Salah3beed/ackerman-steering-car-using-atmega328p/README.md

# Ackerman-Steering-Car-using-ATMega328p
The project files will be uploaded once the uni approves the open source process.
