Salah3beed/ackerman-steering-car-using-atmega328p/Proposal.pdf

# Proposal

# Hand Gesture Controlled Obstacle Avoidance Smart Robotic Car

# Spring 2021-2022

# MCTR601

1

Under supervision of: Prof. Ayman Al Badawy

# Table of Contents

### I. Introduction

i. Team details

ii. Brief intro about the project

### II. Required components

### III. Functional diagram

### IV. Closed Loop control diagram

I. Introduction

The Team:

Name | ID | Tutorial
Salaheldin Mohamed Salah Hussein | 49-18052 | T-32
Shehab Ibrahim | 49-7639 | T-32
Zeyad Tarek | 49-16945 | T-26

Robots are playing an essential part in automation in various areas, including construction, military, medical, and industrial. We used hand motion to drive the car in this project. We have used an accelerometer, which operates on acceleration, for this purpose and we created an ADC converter using 4 channel comparator circuit.

Generally, a transmitting circuit is used in the hand, which contains an RF Transmitter and accelerometer. This will transmit signals to the receiver circuit so that it can do the required task like moving forward, reverse, turning left, turning right and stop.

The accelerometer gives an Analog output so we need to convert these Analog signals into digital. For this purpose, we will use a 4-channel comparator circuit using op amps in place of the ADC (so as to not use an extra microcontroller or an expensive ADC IC). By setting reference voltage, we get a digital signal and then apply this signal to HT12E encoder to encode data or converting it into serial form and then send this data by using RF transmitter into the environment.

At the receiver end, we have used an RF receiver to receive data and then connecting the signals to HT12D decoder. The decoder IC converts received serial data to parallel to be read by the ATMega328p MCU. According to the received data, we drive the car by using two DC motor in forward, reverse, left, right and stop direction.

The robotic car is designed also to avoid any obstacle that may exist along its path, and that is achieved using the ultrasonic sensor attached to the receiver circuit. Using closed loop control, feedback from the sensor, a proportional controller unit makes a correction and this in turn, this changes PWM signal duty cycle, which in turn controls the speed of the motors to change the direction of movement.

II. Required components

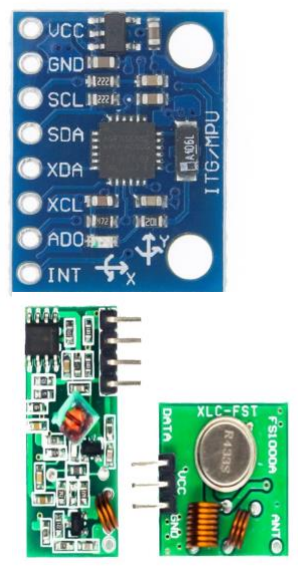
[picture p41: figure]

- ATMega328p
- DC Motors

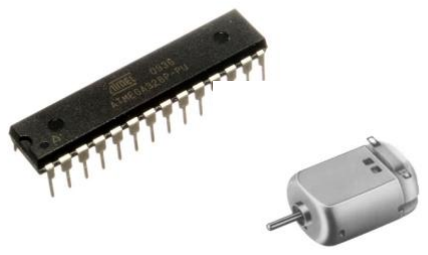
[picture p42: figure]

- Accelerometer MPU 6050 GY-521 (Gyroscope)
- 433Mhz RF Wireless Transmitter and Receiver Kit (aa098)
- HT12E encoder
- HT12D decoder

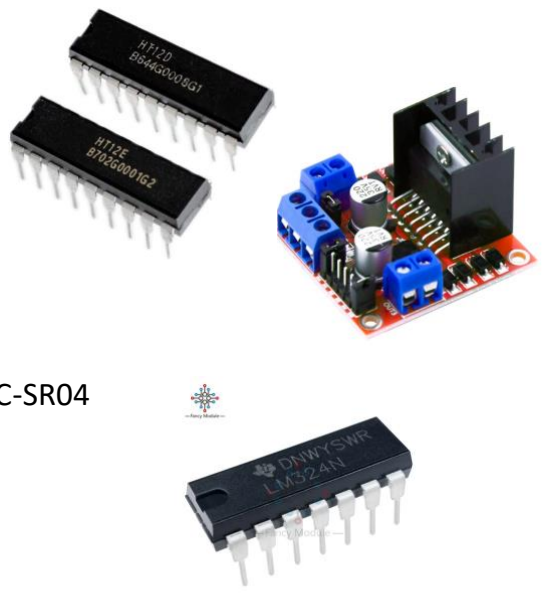
[picture p43: figure]
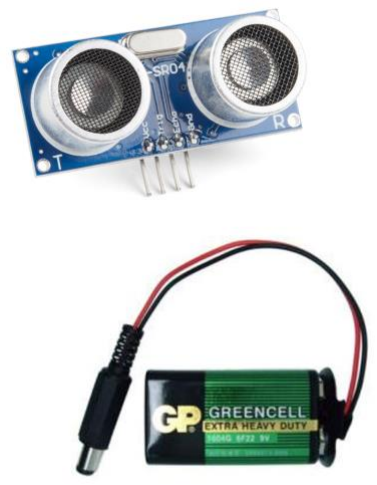
[picture p44: figure]

- Motor Driver L298N
- Ultrasonic sensor HC-SR04
- OP AMP lm324
- 12 Volt Battery
- Battery Connector
- USB cable

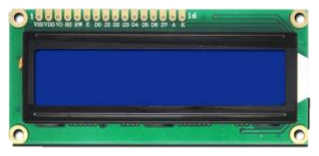
[picture p45: figure]

- Car Chassis

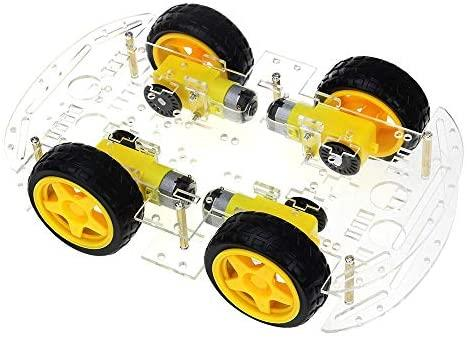
[picture p46: figure]

- LCD (Character LCD 2×16)
- Push Buttons

III. Functional diagram

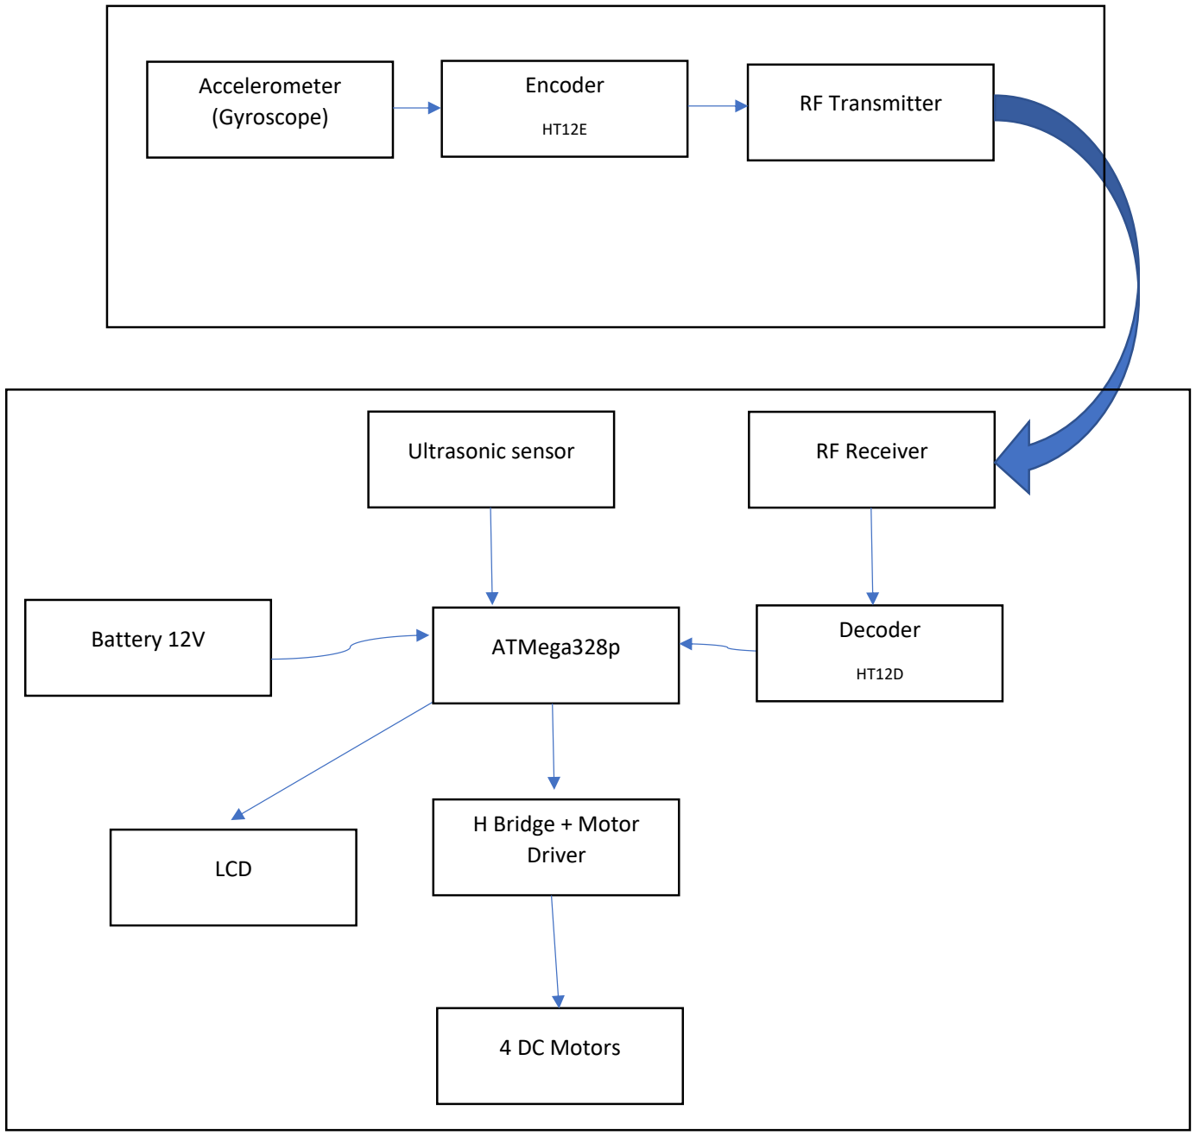
[picture p47: figure]
RF Transmitter; RF Receiver; Accelerometer (Gyroscope); Encoder; ATMega328p Battery 12V; H Bridge + Motor Driver; 4 DC Motors; Decoder; Ultrasonic sensor; LCD

IV. Closed Loop control diagram

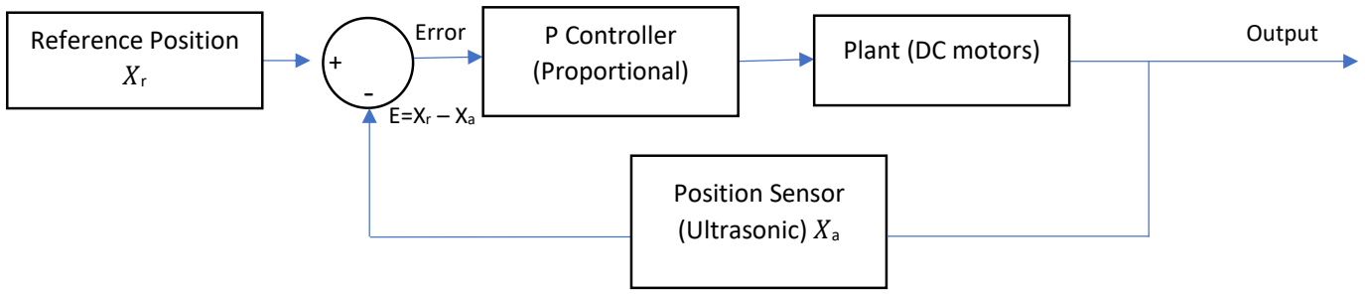
[picture p48: figure]
Position Sensor (Ultrasonic) Xa; Reference Position Xr; P Controller (Proportional); Plant (DC motors); Error; Output
