Salah3beed/ackerman-steering-car-using-atmega328p/(commit log)

2022-06-03 Add: Code for the gyroscope without any calibration
2022-06-10 Add: The arduino connected to hand initial code
2022-06-10 Add: MC MPU+Error C Code
    [Gyro + Error(Calibration).c, Gyro - Error.c]
2022-06-10 Add: Display roll and pitch values on LCD
2022-06-10 Edit: Final Codes without UltraSonic
    the ultrasonic pin echo not working
    [carMain.ino, handArduino.ino]
2022-06-11 Fix: the ultrasonic code
    [carMain.ino]
2022-06-11 Add: FreeRTOS for servo and NRF and backmotors
2022-06-11 Fix: the forward motors
    [carMain.ino, handArduino.ino]
2022-06-11 Edit: Checking where the problem is
    [carMain.ino]
